elillie1/Upwind-Engineering-MAE-342-Project/README.md

# Upwind-Engineering-MAE-342-Project
This is a project on designing a mechanical system for adjustable pitch on a wind turbine for MAE 342 Principles of Mechanical Design.
Group 11 Members: Austin Pocock, Erik Lillie, Juan Martin Casal, Kristofer Lawson, Wyatt Perez, James Rivera.
