elillie1/Upwind-Engineering-MAE-342-Project/turbine design 3/Assembly Turbine Design 3.SLDASM

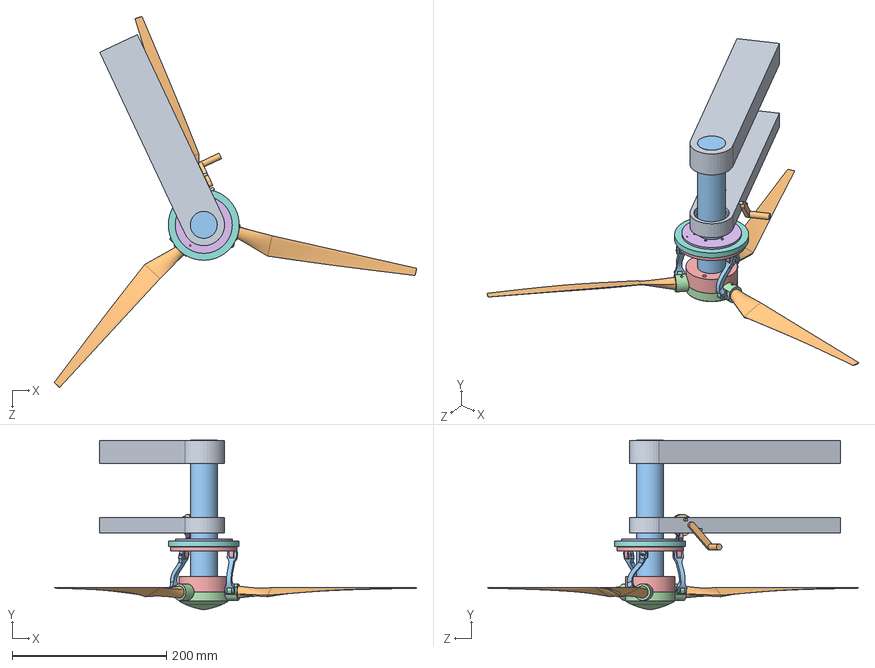
[picture p1: CAD file, 2026-03-24]
turbine design 3/Assembly Turbine Design 3.SLDASM
470.3 x 220.0 x 481.3 mm
Thrust Bearing Inner Hollow
BB 4_5mm x 2
Thrust Bearing Outer Top Above
Thrust Bearing Outer Top Below
Blade Carrier x 3
Blade Linkage x 3
wind turbine blade x 3
Support Beam Bearing
Linear Shaft
Linear Disc
Linear Link x 2
Hub-Bottom
Hub-Top
Shaft 35mm
Linear Handle
Support Beam
