elillie1/Upwind-Engineering-MAE-342-Project/turbine design 3/Hub-Bottom.SLDPRT

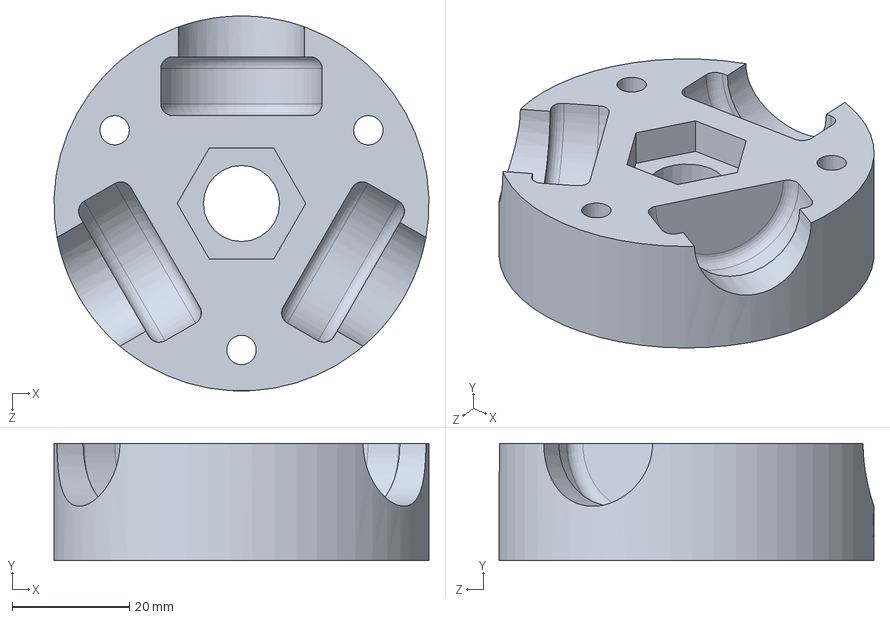
[picture p2: CAD file, 2026-03-24]
turbine design 3/Hub-Bottom.SLDPRT
64.0 x 20.0 x 64.0 mm
