elillie1/Upwind-Engineering-MAE-342-Project/turbine design 3/Thrust Bearing Inner Hollow.SLDPRT

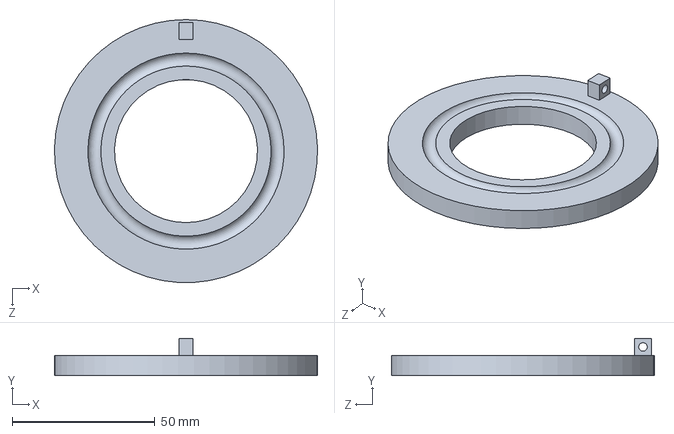
[picture p3: CAD file, 2026-03-24]
turbine design 3/Thrust Bearing Inner Hollow.SLDPRT
92.0 x 13.0 x 91.9 mm
