elillie1/Upwind-Engineering-MAE-342-Project/turbine design 3/Blade Linkage.SLDPRT

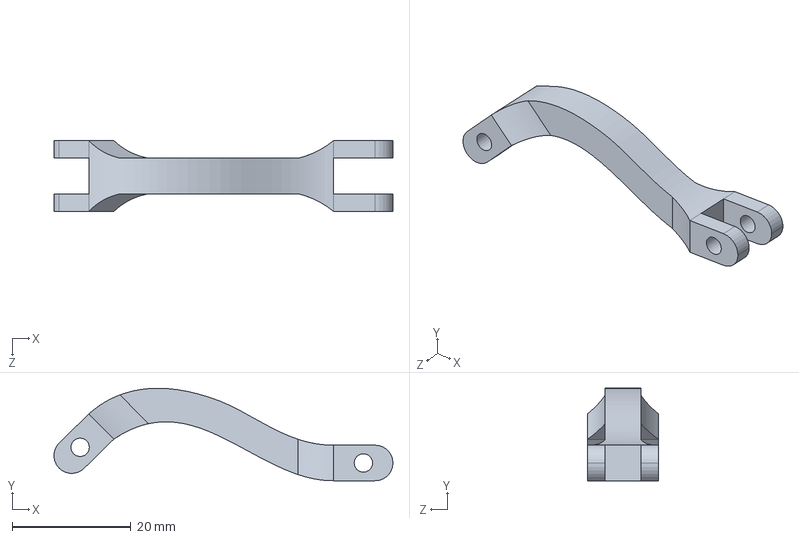
[picture p4: CAD file, 2026-03-24]
turbine design 3/Blade Linkage.SLDPRT
57.2 x 15.6 x 12.0 mm
