elillie1/Upwind-Engineering-MAE-342-Project/turbine design 3/Linear Shaft.SLDPRT

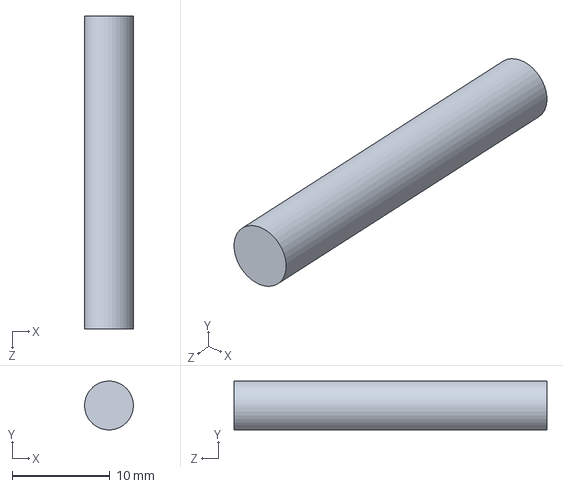
[picture p5: CAD file, 2026-03-24]
turbine design 3/Linear Shaft.SLDPRT
5.00 x 5.00 x 32.0 mm
