elillie1/Upwind-Engineering-MAE-342-Project/turbine design 3/Support Beam.SLDPRT

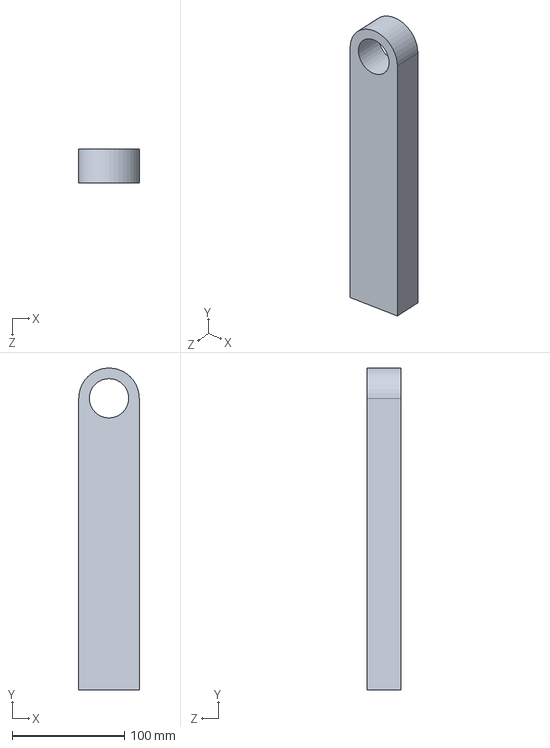
[picture p6: CAD file, 2026-03-24]
turbine design 3/Support Beam.SLDPRT
54.0 x 287.0 x 30.0 mm
