elillie1/Upwind-Engineering-MAE-342-Project/turbine design 3/Linear Link.SLDPRT

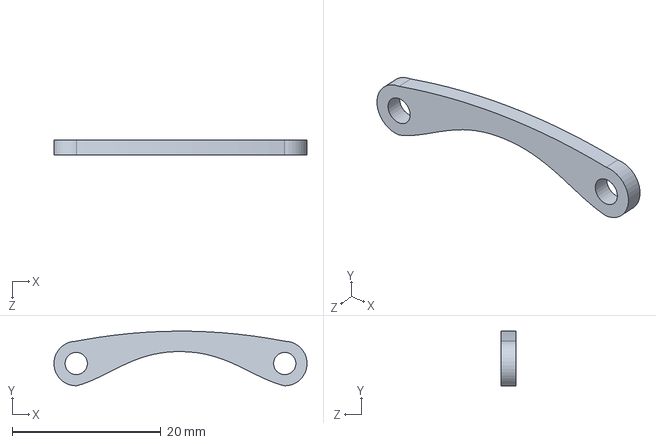
[picture p7: CAD file, 2026-03-24]
turbine design 3/Linear Link.SLDPRT
34.0 x 7.35 x 2.00 mm
