elillie1/Upwind-Engineering-MAE-342-Project/turbine design 3/Blade Carrier.SLDPRT

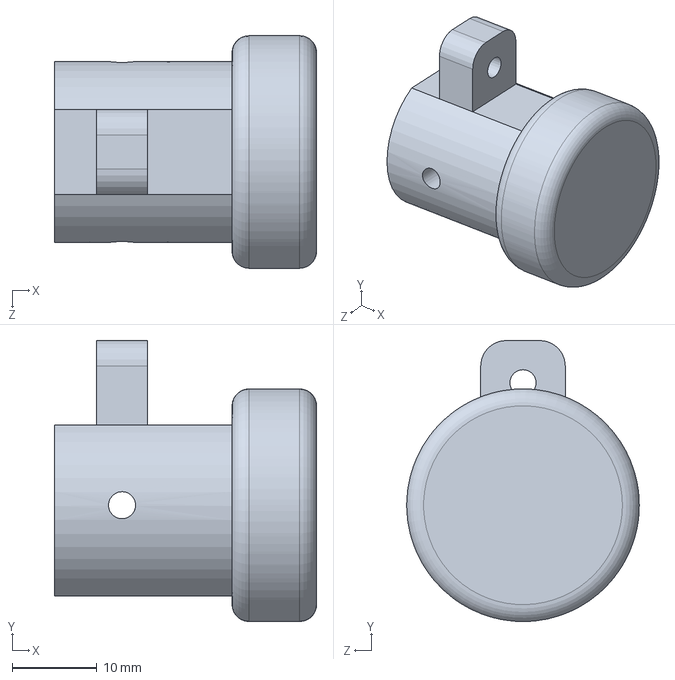
[picture p8: CAD file, 2026-03-24]
turbine design 3/Blade Carrier.SLDPRT
31.0 x 33.2 x 27.5 mm
