elillie1/Upwind-Engineering-MAE-342-Project/turbine design 3/Support Beam Bearing.SLDPRT

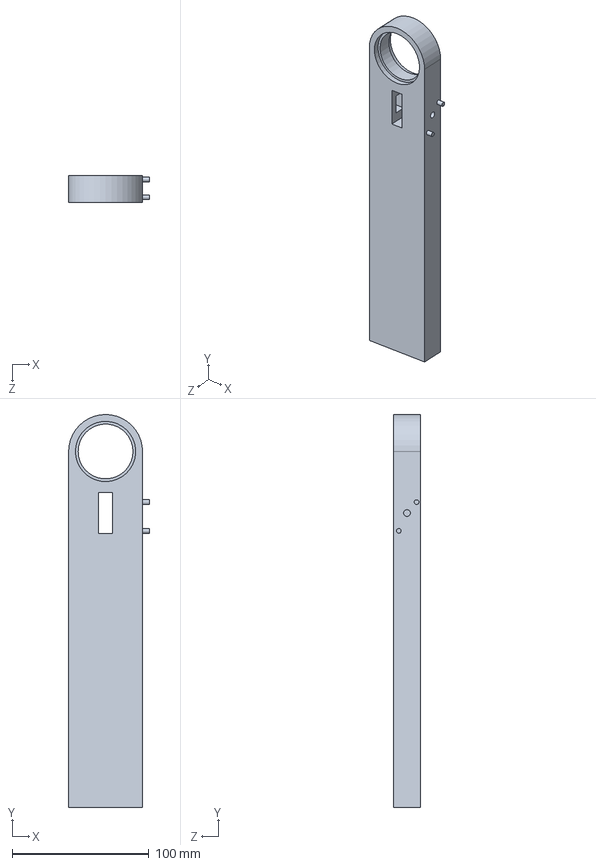
[picture p9: CAD file, 2026-03-24]
turbine design 3/Support Beam Bearing.SLDPRT
59.0 x 287.0 x 20.0 mm
