elillie1/Upwind-Engineering-MAE-342-Project/turbine design 3/Thrust Bearing Outer Top Above.SLDPRT

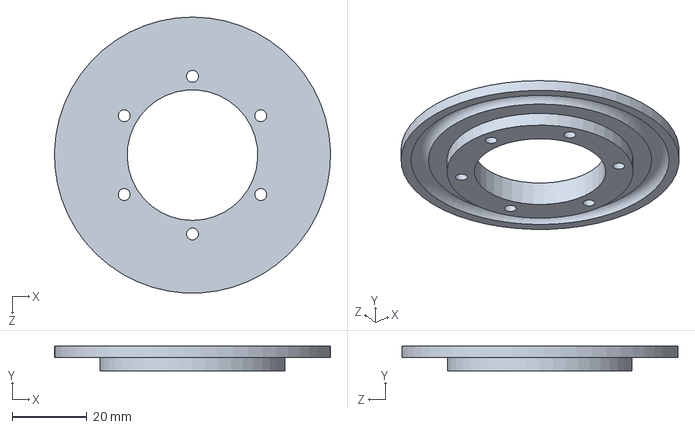
[picture p10: CAD file, 2026-03-24]
turbine design 3/Thrust Bearing Outer Top Above.SLDPRT
74.0 x 6.60 x 73.9 mm
