elillie1/Upwind-Engineering-MAE-342-Project/turbine design 3/Shaft 35mm.SLDPRT

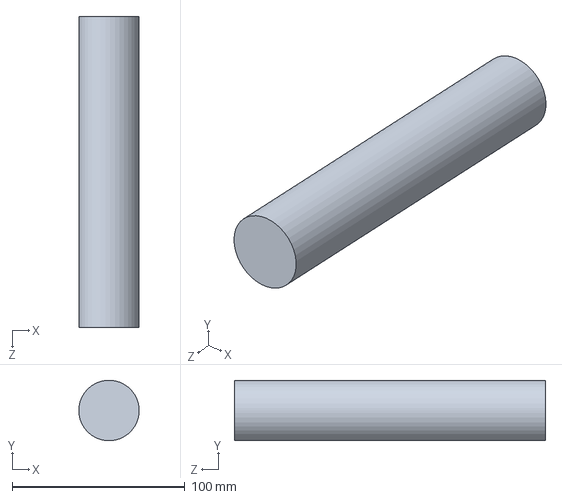
[picture p11: CAD file, 2026-03-24]
turbine design 3/Shaft 35mm.SLDPRT
35.0 x 35.0 x 180.0 mm
