elillie1/Upwind-Engineering-MAE-342-Project/turbine design 3/BB 4_5mm.SLDPRT

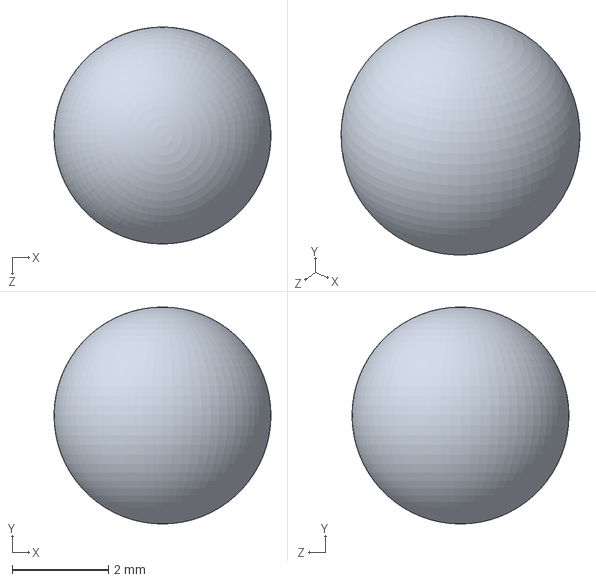
[picture p12: CAD file, 2026-03-24]
turbine design 3/BB 4_5mm.SLDPRT
4.50 x 4.50 x 4.50 mm
