elillie1/Upwind-Engineering-MAE-342-Project/turbine design 3/wind turbine blade.SLDPRT

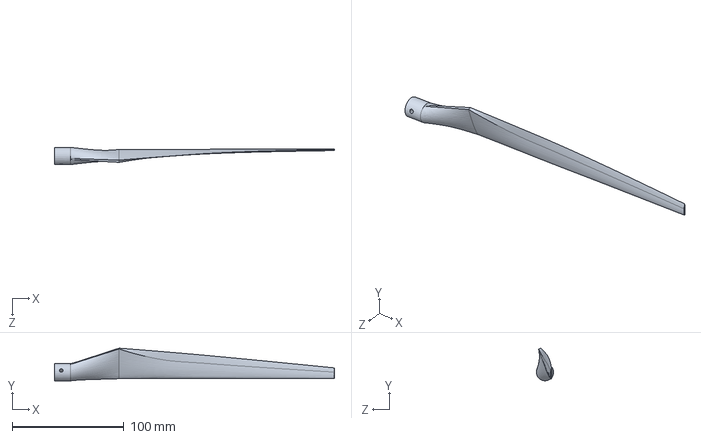
[picture p13: CAD file, 2026-03-24]
turbine design 3/wind turbine blade.SLDPRT
250.0 x 29.2 x 15.4 mm
