elillie1/Upwind-Engineering-MAE-342-Project/turbine design 3/Hub-Top.SLDPRT

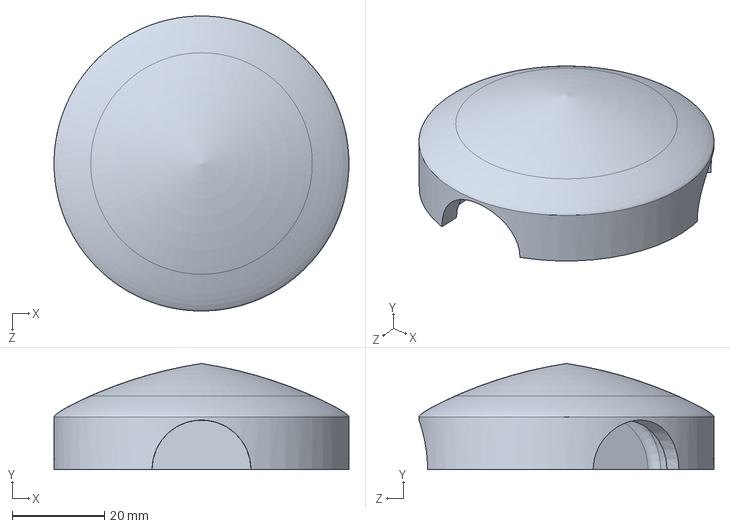
[picture p14: CAD file, 2026-03-24]
turbine design 3/Hub-Top.SLDPRT
64.0 x 23.0 x 64.0 mm
