elillie1/Upwind-Engineering-MAE-342-Project/turbine design 3/Linear Handle.SLDPRT

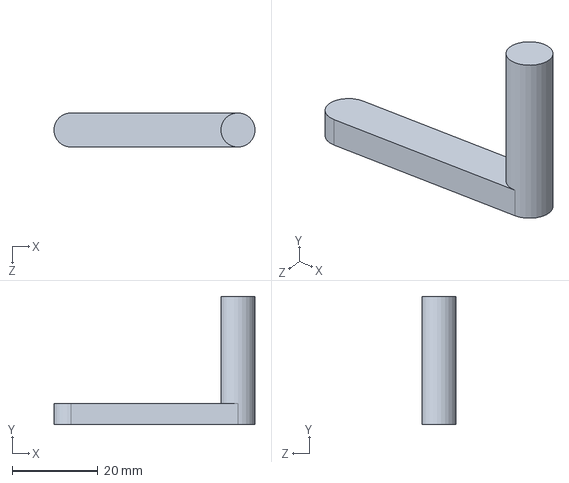
[picture p15: CAD file, 2026-03-24]
turbine design 3/Linear Handle.SLDPRT
46.9 x 30.0 x 8.00 mm
