elillie1/Upwind-Engineering-MAE-342-Project/turbine design 3/Thrust Bearing Outer Top Below.SLDPRT

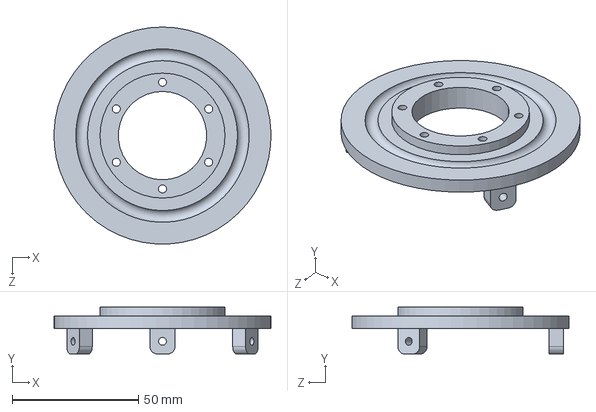
[picture p16: CAD file, 2026-03-24]
turbine design 3/Thrust Bearing Outer Top Below.SLDPRT
86.0 x 18.6 x 85.9 mm
