elillie1/Upwind-Engineering-MAE-342-Project/turbine design 3/Linear Disc.SLDPRT

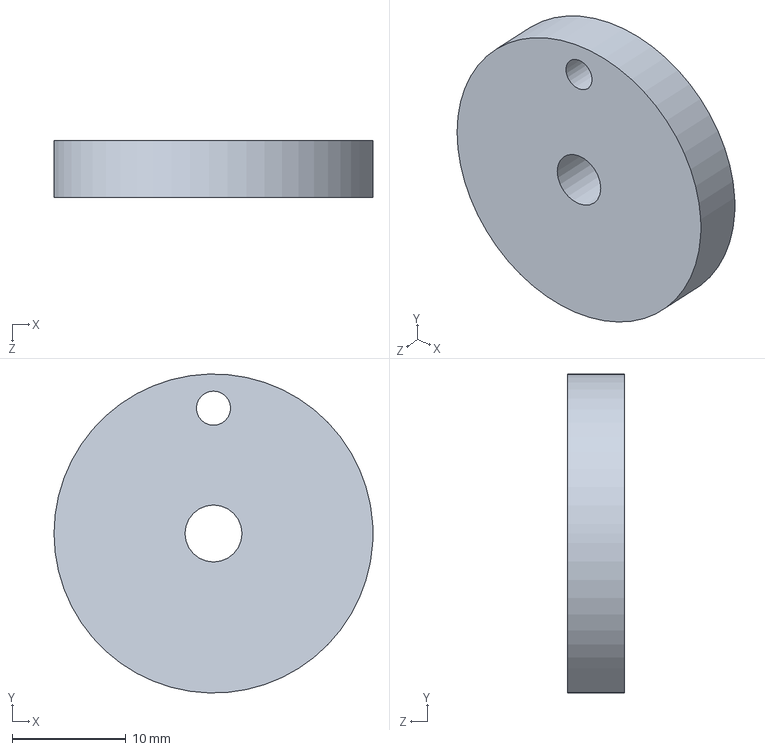
[picture p17: CAD file, 2026-03-24]
turbine design 3/Linear Disc.SLDPRT
28.0 x 28.0 x 5.00 mm
