elillie1/Upwind-Engineering-MAE-342-Project/(list of files, cad)

Other CAD files:
turbine design 3/Drawings/Blade Carrier.SLDDRW
turbine design 3/Drawings/Blade Linkage.SLDDRW
turbine design 3/Drawings/Hub-Bottom.SLDDRW
turbine design 3/Drawings/Hub-Top.SLDDRW
turbine design 3/Drawings/Linear Disc.SLDDRW
turbine design 3/Drawings/Linear Handle.SLDDRW
turbine design 3/Drawings/Linear Link.SLDDRW
turbine design 3/Drawings/Linear Shaft.SLDDRW
turbine design 3/Drawings/Shaft 35mm.SLDDRW
turbine design 3/Drawings/Support Beam Bearing.SLDDRW
turbine design 3/Drawings/Support Beam.SLDDRW
turbine design 3/Drawings/Thrust Bearing Inner Hollow.SLDDRW
turbine design 3/Drawings/Thrust Bearing Outer Top Above.SLDDRW
turbine design 3/Drawings/Thrust Bearing Outer Top Below.SLDDRW
turbine design 3/Drawings/radial ball bearing.SLDDRW
turbine design 3/Drawings/wind turbine blade.SLDDRW
