elillie1/Upwind-Engineering-MAE-342-Project/(commit log)

2026-03-24 CAD files
    CAD files and drawings
    [Assembly Turbine Design 3.SLDASM, BB 4_5mm.SLDPRT, Blade Carrier.SLDDRW, Blade Carrier.SLDPRT, Blade Linkage.SLDDRW, Blade Linkage.SLDPRT, Hub-Bottom.SLDDRW, Hub-Bottom.SLDPRT]
2026-03-26 Rename Turbine STL.STL to TurbineSTL.STL
    [TurbineSTL.STL]
2026-03-26 Rename TurbineSTL.STL to Turbine STL.STL
    [Turbine STL.STL]
